RobHumphris/EngineBalancer/images/balancer.jpg

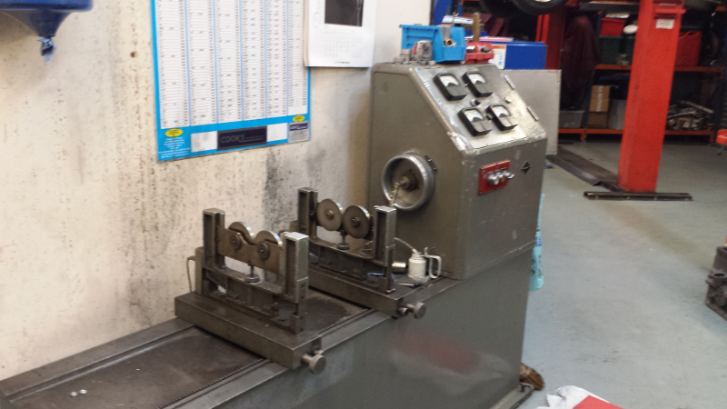
images/balancer.jpg
