RobHumphris/EngineBalancer/images/load-cell.jpg

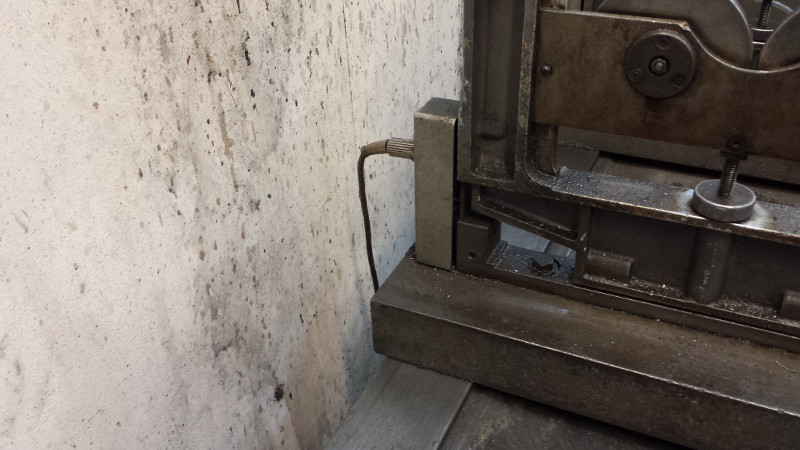
images/load-cell.jpg
