RobHumphris/EngineBalancer/python/settings.py

SCREEN = (0x4E, 0x4D, 0x4A)
AXISCOLOUR = (0x94, 0xBA, 0x65)
SENSORACOLOUR = (0xFF, 0x00, 0x00)
SENSORBCOLOUR = (0x00, 0x00, 0xFF)
STATUSCOLOUR = (0x27, 0x90, 0xB0)
POSITIONCOLOUR = STATUSCOLOUR
WIDTH = 800
HEIGHT = 480
AXISLENGTH = 720
AXISHEIGHT = 400
STARTX = 40
STARTY = 25
XSCALAR = AXISLENGTH / 360
YSCALAR = AXISHEIGHT / 200
PLOTXSCALAR = AXISLENGTH / 90
ANGLE_MULTIPLE = 4
ARRAY_SIZE = 90

GRAPHLINEX = (AXISLENGTH / 2) + STARTX
GRAPHLABLEX = GRAPHLINEX + 10
GRAPHLINEY = (AXISHEIGHT / 2) + STARTY
GRAPHLABLEY = GRAPHLINEY + 10

SAMPLE_COUNT = 10


FONT_NAME = "Helvetica"

BTN_UNCLICKED = (0x2B, 0x4E, 0x72)
BTN_CLICKED = (0x27, 0x90, 0xB0)
BTN_FOREGROUND = (0xFF, 0xFF, 0xFF)

COM_PORT = 'COM3'
COM_BAUD = 115200
#COM_BAUD = 256000
