RobHumphris/EngineBalancer/arduino/interruptDrivenSensorTest/interruptDrivenSensorTest.ino

#define TRIGGER_TEETH 360
#define BAUD_RATE 115200
#define READING_DELAY 100

void setup() {
  Serial.begin(BAUD_RATE);
  Serial.println("Setup Complete.");
}

void sendCalibration() {
  Serial.println("C,317,54");
  delay(100);
}

void sendData() {
  Serial.println("R491,350,54,360,54,359,54,375,54,363,55,376,55,365,54,369,54,358,54,359,54,345,55,346,54,346,54,349,54,350,55,361,54,366,54,359,55,371,54,363,55,372,54,370,55,363,54,364,55,370,55,359,54,363,54,356,54,359,55,354,54,370,54,358,54,373,53,365,55,364,55,361,55,358,54,360,55,354,54,354,54,351,54,347,54,347,54,345,54,350,54,345,55,354,54,365,54,368,55,363,55,359,54,364,55,366,54,369,54,366,55,368,54,358,55,351,54,352,54,352,54,357,54,365,54,361,54,358,54,356,54,356,54,359,54,356,54,361,54,365,55,367,54,355,54,352,55,355,55,357,55,351,54,353,54,353,54,361,55,360,55,368,54,370,54,369,55,367,54,374,55,364,55,358,54,359,54,364,55,");    delay(READING_DELAY);
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
}

void loop() {
  int i;
  while(true) {
    for (i=0; i < 10; i++) {
      sendCalibration();
    }
    for (i=0; i < 10; i++) {
      sendData();
    }
  }
}
