RobHumphris/EngineBalancer/(commit log)

2017-03-04 First cut of interrupt driven sensor code
2017-06-10 Tested changes to Arduino code
2017-06-15 Next cut
2017-06-18 Button class more self-contained
2017-07-10 Script working with Arduino test program
2017-07-10 Cleaned up signal trace
2017-07-11 Self zero'ing sensor channels
2017-07-26 live changes - now we use moving average filters
2025-11-11 Add piezoVibration sketch for sensor readings
    Initialize LED and sensor pins, and read analog values.
